quaternionrotation/Athena-Flight-Computer/README.md

 :)
