quaternionrotation/Athena-Flight-Computer/Athena/Athena.kicad_pcb

## KiCad design Athena/Athena.kicad_pcb (2025-09-25)

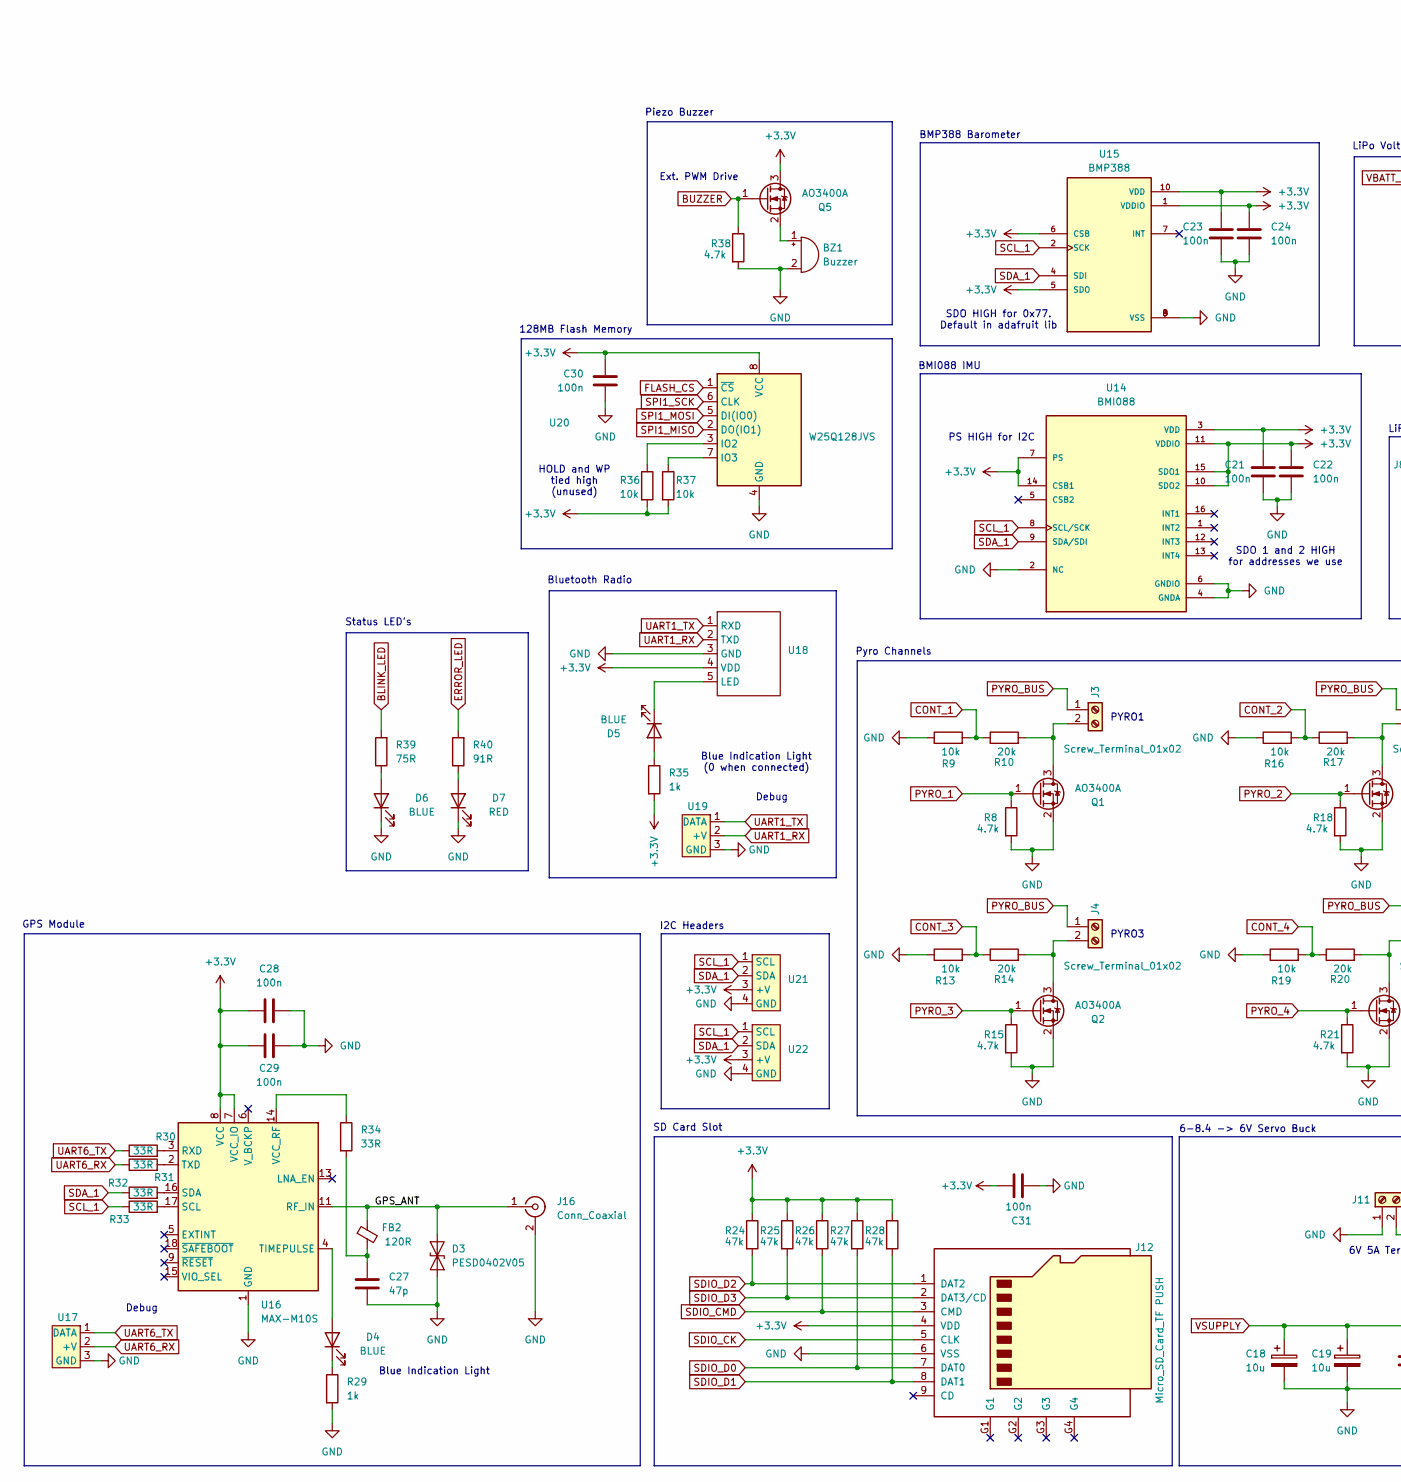
[picture p1: schematic Athena.kicad_sch, Athena Flight Computer, part in row 1, column 1]

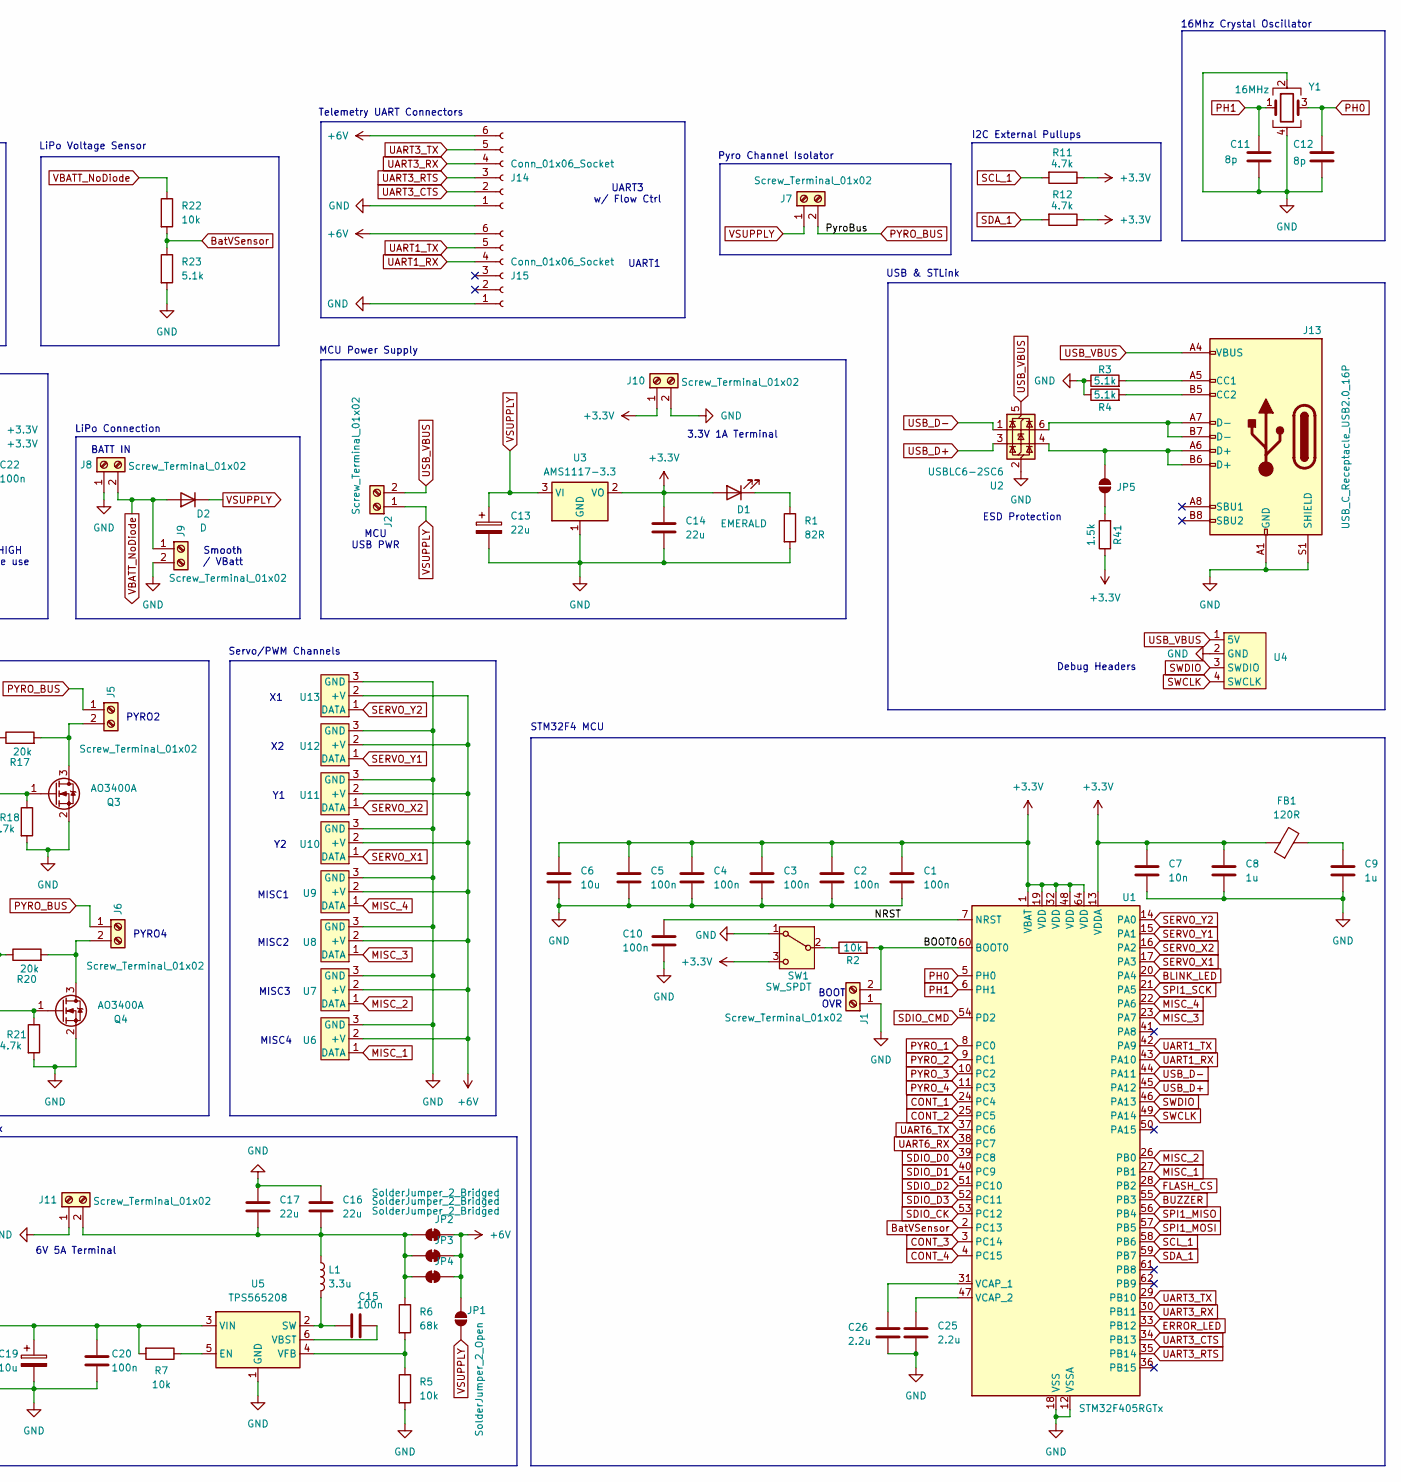
[picture p2: schematic Athena.kicad_sch, Athena Flight Computer, part in row 1, column 2]

Parts:
BZ1: Buzzer; Buzzer_TDK_PS1240P02BT_D12.2mm_H6.5mm
C1, C2, C3, C4, C5, C10, C15, C20, C21, C22, C23, C24, C28, C29, C30, C31: 100n; C_0603_1608Metric
C6: 10u; C_0603_1608Metric
C7: 10n; C_0603_1608Metric
C8, C9: 1u; C_0603_1608Metric
C11, C12: 8p; C_0603_1608Metric
C13: 22u; CP_EIA-3216-10_Kemet-I
C14, C16, C17: 22u; C_0603_1608Metric
C18, C19: 10u; CP_EIA-3528-12_Kemet-T
C25, C26: 2.2u; C_0603_1608Metric
C27: 47p; C_0603_1608Metric
D1: EMERALD; LED_0805_2012Metric
D2: D; D_SMB
D3: PESD0402V05; D_0402_1005Metric
D4, D5, D6: BLUE; LED_0603_1608Metric
D7: RED; LED_0603_1608Metric
FB1, FB2: 120R; L_0603_1608Metric
J1, J2, J3, J4, J5, J6, J7, J8, J9, J10, J11: Screw_Terminal_01x02; TerminalBlock_bornier-2_P5.08mm
J12: Micro_SD_Card_TF PUSH; SUNTECH_ST-TF-003A
J13: USB_C_Receptacle_USB2.0_16P; USB_C_Receptacle_GCT_USB4105-xx-A_16P_TopMnt_Horizontal
J14, J15: Conn_01x06_Socket; JST_GH_SM06B-GHS-TB_1x06-1MP_P1.25mm_Horizontal
J16: Conn_Coaxial; U.FL_Hirose_U.FL-R-SMT-1_Vertical
JP1, JP5: SolderJumper_2_Open; SolderJumper-2_P1.3mm_Open_Pad1.0x1.5mm
JP2, JP3, JP4: SolderJumper_2_Bridged; SolderJumper-2_P1.3mm_Bridged_Pad1.0x1.5mm
L1: 3.3u; IND_CYA0630_SHH
Q1, Q2, Q3, Q4, Q5: AO3400A; SOT-23
R1: 82R; R_0603_1608Metric
R2, R5, R7, R9, R13, R16, R19, R22, R36, R37: 10k; R_0603_1608Metric
R3, R4, R23: 5.1k; R_0603_1608Metric
R6: 68k; R_0603_1608Metric
R8, R11, R12, R15, R18, R21, R38: 4.7k; R_0603_1608Metric
R10, R14, R17, R20: 20k; R_0603_1608Metric
R24, R25, R26, R27, R28: 47k; R_0603_1608Metric
R29, R35: 1k; R_0603_1608Metric
R30, R31, R32, R33, R34: 33R; R_0603_1608Metric
R39: 75R; R_0603_1608Metric
R40: 91R; R_0603_1608Metric
R41: 1.5k; R_0603_1608Metric
SW1: SW_SPDT; SW_SS12D07VG4
U1: STM32F405RGTx; LQFP-64_10x10mm_P0.5mm
U2: USBLC6-2SC6; SOT-23-6
U3: AMS1117-3.3; SOT-223-3_TabPin2
U4, U21, U22: PinHeader_1x04_P2.54mm_Vertical
U5: TPS565208; SOT-23-6
U6, U7, U8, U9, U10, U11, U12, U13, U17, U19: PinHeader_1x03_P2.54mm_Vertical
U14: BMI088; PQFN50P450X300X100-16N
U15: BMP388; PQFN50P200X200X80-10N; PARTREV 1.1
U16: MAX-M10S; ublox_MAX
U18: VG6328A
U20: W25Q128JVS; SOIC-8_5.23x5.23mm_P1.27mm
Y1: 16MHz; Crystal_SMD_SeikoEpson_TSX3225-4Pin_3.2x2.5mm

Connections:
+3.3V: C1.1, C2.1, C3.1, C4.1, C5.1, C6.1, C7.1, C8.1, C14.1, C21.1, C22.1, C23.1, C24.1, C28.1, C29.1, C30.1, C31.1, D1.2 (A), FB1.1, J10.1, J12.4 (VDD), Q5.3 (D), R11.1, R12.1, R24.1, R25.1, R26.1, R27.1, R28.1, R35.2, R36.2, R37.2, R41.1, SW1.3 (C), U1.1 (VBAT), U1.13 (VDDA), U1.19 (VDD), U1.32 (VDD), U1.48 (VDD), U1.64 (VDD), U3.2 (VO), U14.3 (VDD), U14.7 (PS), U14.10 (SDO2), U14.11 (VDDIO), U14.14 (CSB1), U14.15 (SDO1), U15.1 (VDDIO), U15.5 (SDO), U15.6 (CSB), U15.10 (VDD), U16.7 (VCC_IO), U16.8 (VCC), U18.4 (VDD), U20.8 (VCC), U21.3 (+V), U22.3 (+V)
+6V: J14.6, J15.6, JP1.2 (B), JP2.2 (B), JP3.2 (B), JP4.2 (B), U6.2 (+V), U7.2 (+V), U8.2 (+V), U9.2 (+V), U10.2 (+V), U11.2 (+V), U12.2 (+V), U13.2 (+V)
/BOOT0: J1.2, R2.2, U1.60 (BOOT0)
/GPS_ANT: D3.1 (A1), FB2.1, J16.1 (In), U16.11 (RF_IN)
/NRST: C10.1, U1.7 (NRST)
BLINK_LED: R39.2, U1.20 (PA4)
BUZZER: Q5.1 (G), R38.1, U1.55 (PB3)
BatVSensor: R22.2, R23.1, U1.2 (PC13)
CONT_1: R9.2, R10.1, U1.24 (PC4)
CONT_2: R16.2, R17.1, U1.25 (PC5)
CONT_3: R13.2, R14.1, U1.3 (PC14)
CONT_4: R19.2, R20.1, U1.4 (PC15)
ERROR_LED: R40.2, U1.33 (PB12)
FLASH_CS: U1.28 (PB2), U20.1 (~CS)
GND: BZ1.2 (-), C1.2, C2.2, C3.2, C4.2, C5.2, C6.2, C7.2, C8.2, C9.2, C10.2, C11.2, C12.2, C13.2, C14.2, C16.1, C17.1, C18.2, C19.2, C20.2, C21.2, C22.2, C23.2, C24.2, C25.2, C26.2, C27.2, C28.2, C29.2, C30.2, C31.2, D3.2 (A2), D6.1 (K), D7.1 (K), J1.1, J8.1, J9.2, J10.2, J11.1, J12.6 (VSS), J13.A1 (GND), J13.A12 (GND), J13.B1 (GND), J13.B12 (GND), J13.S1 (SHIELD), J14.1, J15.1, J16.2 (Ext), Q1.2 (S), Q2.2 (S), Q3.2 (S), Q4.2 (S), R1.2, R3.1, R4.1, R5.2, R8.2, R9.1, R13.1, R15.2, R16.1, R18.2, R19.1, R21.2, R23.2, R29.2, R38.2, SW1.1 (A), U1.12 (VSSA), U1.18 (VSS), U1.63 (VSS), U2.2 (GND), U3.1 (GND), U4.2 (GND), U5.1 (GND), U6.3 (GND), U7.3 (GND), U8.3 (GND), U9.3 (GND), U10.3 (GND), U11.3 (GND), U12.3 (GND), U13.3 (GND), U14.2 (NC), U14.4 (GNDA), U14.6 (GNDIO), U15.3 (VSS), U15.8 (VSS), U15.9 (VSS), U16.1 (GND), U16.10 (GND), U16.12 (GND), U17.3 (GND), U18.3 (GND), U19.3 (GND), U20.4 (GND), U21.4 (GND), U22.4 (GND), Y1.2, Y1.4
MISC_1: U1.27 (PB1), U6.1 (DATA)
MISC_2: U1.26 (PB0), U7.1 (DATA)
MISC_3: U1.23 (PA7), U8.1 (DATA)
MISC_4: U1.22 (PA6), U9.1 (DATA)
unnamed: BZ1.1 (+), Q5.2 (S)
unnamed: C9.1, FB1.2
unnamed: C27.1, FB2.2, R34.2
unnamed: D1.1 (K), R1.1
unnamed: D4.2 (A), U16.4 (TIMEPULSE)
unnamed: D4.1 (K), R29.1
unnamed: D5.2 (A), R35.1
unnamed: D5.1 (K), U18.5 (LED)
unnamed: D6.2 (A), R39.1
unnamed: D7.2 (A), R40.1
unnamed: J3.2, Q1.3 (D), R10.2
unnamed: J4.2, Q2.3 (D), R14.2
unnamed: J5.2, Q3.3 (D), R17.2
unnamed: J6.2, Q4.3 (D), R20.2
unnamed: C16.2, C17.2, J11.2, JP2.1 (A), JP3.1 (A), JP4.1 (A), L1.1, R6.1
unnamed: J13.A5 (CC1), R3.2
unnamed: J13.B5 (CC2), R4.2
unnamed: J13.A7 (D-), J13.B7 (D-), U2.6 (I/O1)
unnamed: JP5.1 (A), R41.2
unnamed: J13.A6 (D+), J13.B6 (D+), JP5.2 (B), U2.4 (I/O2)
unnamed: R2.1, SW1.2 (B)
unnamed: C26.1, U1.31 (VCAP_1)
unnamed: C25.1, U1.47 (VCAP_2)
unnamed: R7.1, U5.5 (EN)
unnamed: C15.1, L1.2, U5.2 (SW)
unnamed: C15.2, U5.6 (VBST)
unnamed: R5.1, R6.2, U5.4 (VFB)
unnamed: R30.2, U16.3 (RXD)
unnamed: R33.2, U16.17 (SCL)
unnamed: R32.2, U16.16 (SDA)
unnamed: R31.2, U16.2 (TXD)
unnamed: R34.1, U16.14 (VCC_RF)
unnamed: R36.1, U20.3 (IO2)
unnamed: R37.1, U20.7 (IO3)
PH0: C12.1, U1.5 (PH0), Y1.3
PH1: C11.1, U1.6 (PH1), Y1.1
PYRO_1: Q1.1 (G), R8.1, U1.8 (PC0)
PYRO_2: Q3.1 (G), R18.1, U1.9 (PC1)
PYRO_3: Q2.1 (G), R15.1, U1.10 (PC2)
PYRO_4: Q4.1 (G), R21.1, U1.11 (PC3)
PYRO_BUS: J3.1, J4.1, J5.1, J6.1, J7.2
SCL_1: R11.2, R33.1, U1.58 (PB6), U14.8 (SCL/SCK), U15.2 (SCK), U21.1 (SCL), U22.1 (SCL)
SDA_1: R12.2, R32.1, U1.59 (PB7), U14.9 (SDA/SDI), U15.4 (SDI), U21.2 (SDA), U22.2 (SDA)
SDIO_CK: J12.5 (CLK), U1.53 (PC12)
SDIO_CMD: J12.3 (CMD), R26.2, U1.54 (PD2)
SDIO_D0: J12.7 (DAT0), R27.2, U1.39 (PC8)
SDIO_D1: J12.8 (DAT1), R28.2, U1.40 (PC9)
SDIO_D2: J12.1 (DAT2), R24.2, U1.51 (PC10)
SDIO_D3: J12.2 (DAT3/CD), R25.2, U1.52 (PC11)
SERVO_X1: U1.17 (PA3), U10.1 (DATA)
SERVO_X2: U1.16 (PA2), U11.1 (DATA)
SERVO_Y1: U1.15 (PA1), U12.1 (DATA)
SERVO_Y2: U1.14 (PA0), U13.1 (DATA)
SPI1_MISO: U1.56 (PB4), U20.2 (DO(IO1))
SPI1_MOSI: U1.57 (PB5), U20.5 (DI(IO0))
SPI1_SCK: U1.21 (PA5), U20.6 (CLK)
SWCLK: U1.49 (PA14), U4.4 (SWCLK)
SWDIO: U1.46 (PA13), U4.3 (SWDIO)
UART1_RX: J15.4, U1.43 (PA10), U18.2 (TXD), U19.2 (+V)
UART1_TX: J15.5, U1.42 (PA9), U18.1 (RXD), U19.1 (DATA)
UART3_CTS: J14.2, U1.34 (PB13)
UART3_RTS: J14.3, U1.35 (PB14)
UART3_RX: J14.4, U1.30 (PB11)
UART3_TX: J14.5, U1.29 (PB10)
UART6_RX: R31.1, U1.38 (PC7), U17.2 (+V)
UART6_TX: R30.1, U1.37 (PC6), U17.1 (DATA)
USB_D+: U1.45 (PA12), U2.3 (I/O2)
USB_D-: U1.44 (PA11), U2.1 (I/O1)
USB_VBUS: J2.2, J13.A4 (VBUS), J13.A9 (VBUS), J13.B4 (VBUS), J13.B9 (VBUS), U2.5 (VBUS), U4.1 (5V)
VBATT_NoDiode: D2.2 (A), J8.2, J9.1, R22.1
VSUPPLY: C13.1, C18.1, C19.1, C20.1, D2.1 (K), J2.1, J7.1, JP1.1 (A), R7.2, U3.3 (VI), U5.3 (VIN)

Notes on the sheet:
I2C Headers
LiPo Connection
6V 5A Terminal
Telemetry UART Connectors
BATT IN
Piezo Buzzer
16Mhz Crystal Oscillator
Pyro Channels
128MB Flash Memory
Bluetooth Radio
BOOT OVR
UART1
PYRO3
LiPo Voltage Sensor
MCU Power Supply
I2C External Pullups
SDO HIGH for 0x77. Default in adafruit lib
PYRO4
Debug
HOLD and WP tied high (unused)
Blue Indication Light
ESD Protection
Ext. PWM Drive
GPS Module
Status LED's
BMI088 IMU
6-8.4 -> 6V Servo Buck
Blue Indication Light (0 when connected)
PYRO1
3.3V 1A Terminal
SDO 1 and 2 HIGH for addresses we use
STM32F4 MCU
UART3 w/ Flow Ctrl
Debug Headers
MISC2
MISC4
PYRO2
MISC3
Pyro Channel Isolator
MISC1
SD Card Slot
BMP388 Barometer
MCU USB PWR
USB & STLink
PS HIGH for I2C
Servo/PWM Channels
Smooth / VBatt

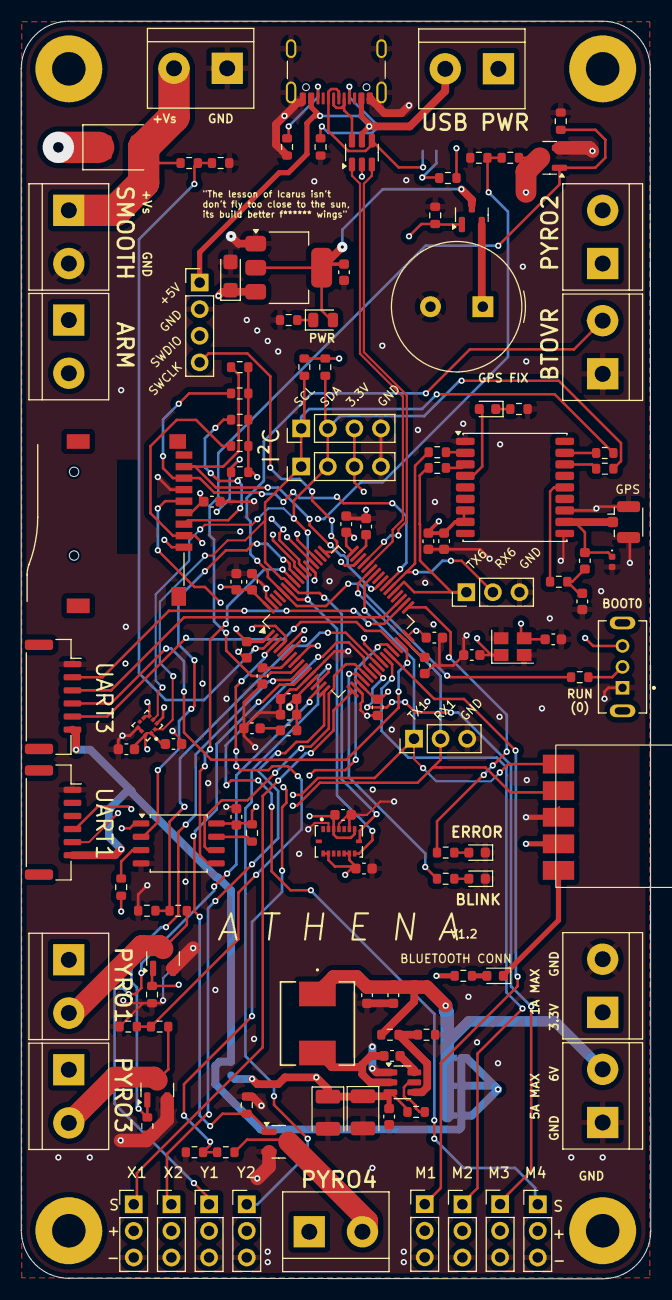
[picture p3: board Athena.kicad_pcb from above]

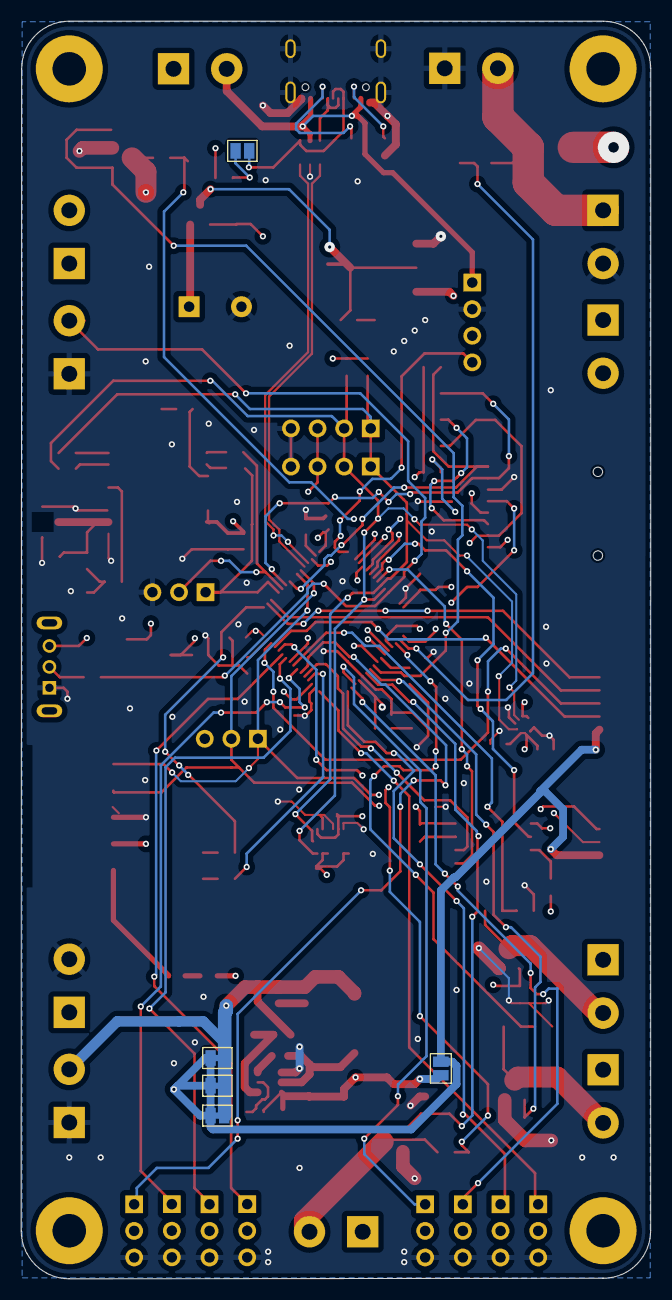
[picture p4: board Athena.kicad_pcb from below]

Board: 4 copper layers, 60.1 x 120.1 mm, 133 parts (5 on the bottom side), 90 nets.
