quaternionrotation/Athena-Flight-Computer/(commit log)

2025-09-25 Fixed NASA Worm Font
    [Athena.kicad_pcb]
2025-09-25 updated schematic to KiCad 9
    [Athena.kicad_sch]
